aprsworld/dcswc_moduble_voltage_current_counter/hardware/dcswc_module_voltage_current_counter.pdf

## ICSP_PGD

## ICSP_PGC

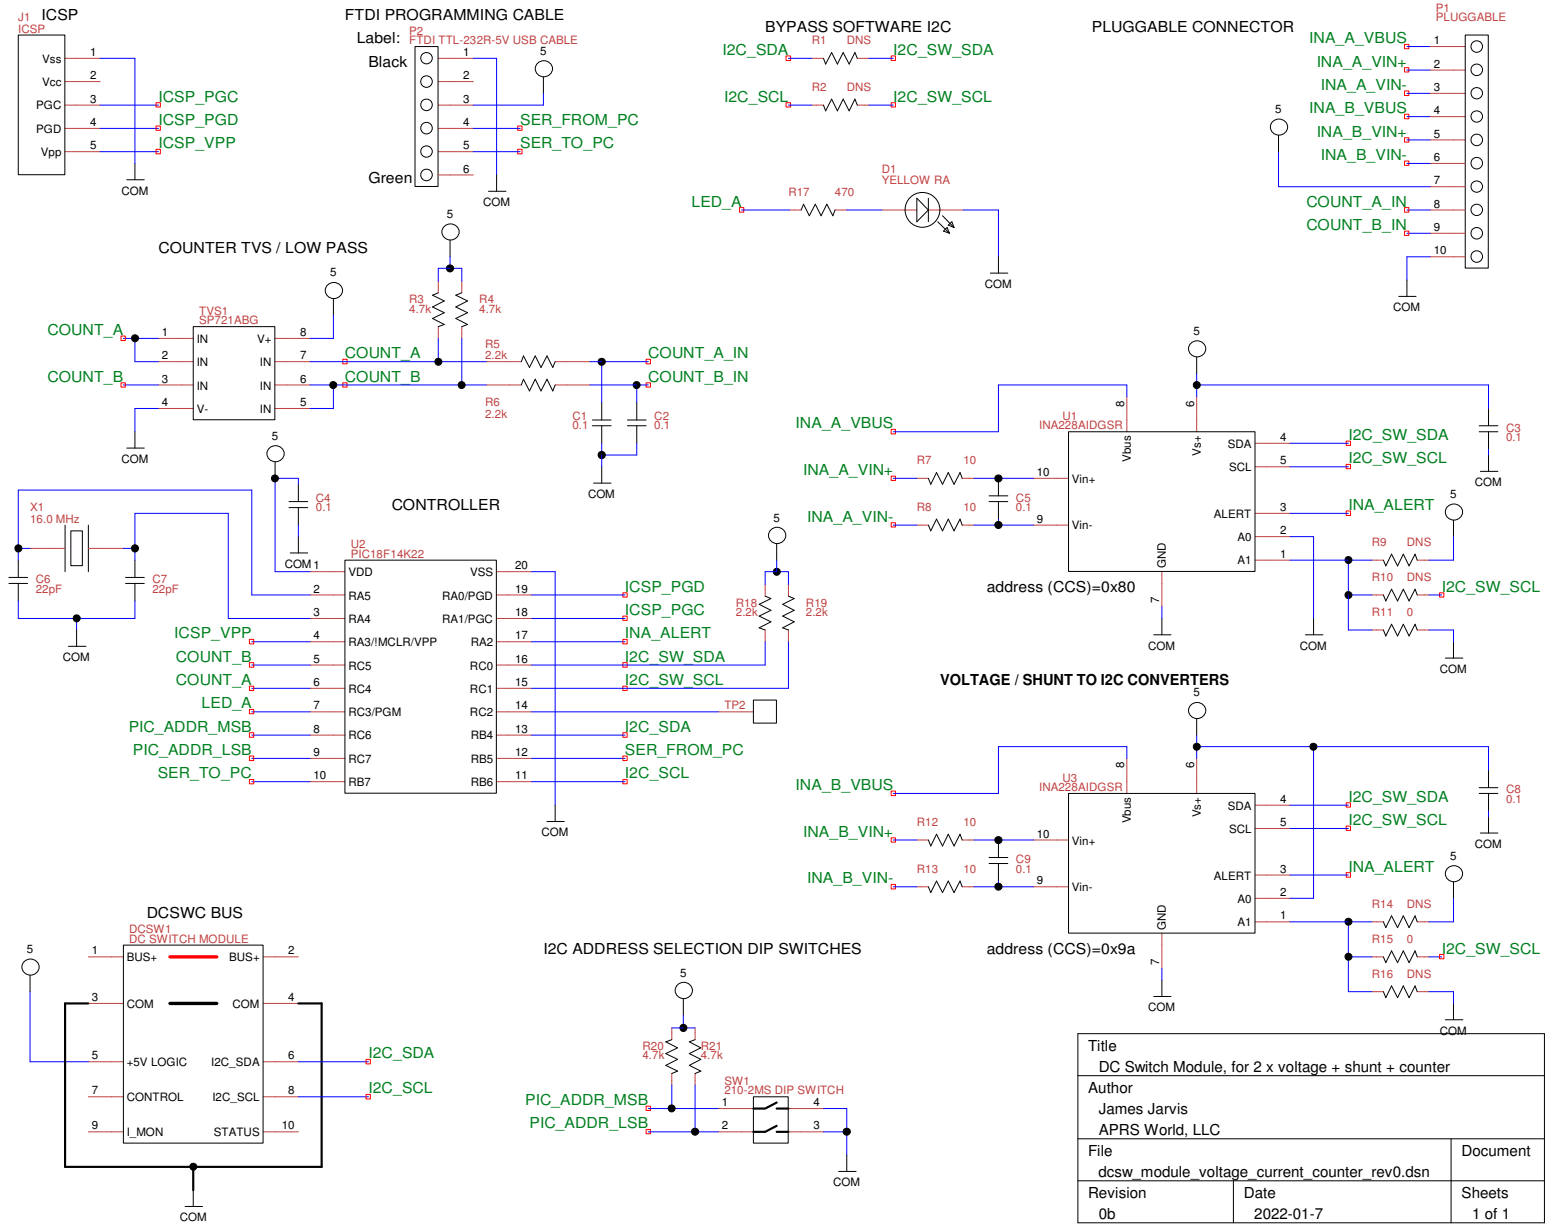
[picture p1: page 1]

COUNTER TVS / LOW PASS

I2C ADDRESS SELECTION DIP SWITCHES

Title
DC Switch Module, for 2 x voltage + shunt + counter
Author
James Jarvis
APRS World, LLC

File ... dcsw_module_voltage_current_counter_rev0.dsn | Document

Revision 0b | Date 2022-01-7 | Sheets 1 of 1
