aprsworld/dcswc_moduble_voltage_current_counter/param_dcswc_module_voltage_current_counter.c

#inline
char xor_crc(char oldcrc, char data) {
	return oldcrc ^ data;
}

char EEPROMDataRead( int16 address, int8 *data, int16 count ) {
	char crc=0;

	while ( count-- != 0 ) {
		*data = read_eeprom( address++ );
		crc = xor_crc(crc,*data);
		data++;
	}
	return crc;
}

char EEPROMDataWrite( int16 address, int8 *data, int16 count ) {
	char crc=0;

	while ( count-- != 0 ) {
		/* restart_wdt() */
		crc = xor_crc(crc,*data);
		write_eeprom( address++, *data++ );
	}

	return crc;
}

void write_param_file() {
	int8 crc;

	/* write the config structure */
	crc = EEPROMDataWrite(PARAM_ADDRESS,(void *)&config,sizeof(config));
	/* write the CRC was calculated on the structure */
	write_eeprom(PARAM_CRC_ADDRESS,crc);
}

void write_default_param_file() {
	current.default_params_written=1;

	/* both LEDs on */
	timers.led_on_a=150;

	config.serial_prefix='P';
	config.serial_number=9872;


	config.startup_power_on_delay=5;

	/* write them so next time we use from EEPROM */
	write_param_file();

}


void read_param_file() {
	int8 crc;

	crc = EEPROMDataRead(PARAM_ADDRESS, (void *)&config, sizeof(config)); 
		
	if ( crc != read_eeprom(PARAM_CRC_ADDRESS) ) {
		write_default_param_file();
	}
}
