aprsworld/dcswc_moduble_voltage_current_counter/(commit log)

2022-01-07 Working on getting software I2C master working
2022-01-08 Getting there. Trying to reduce counter jitter
    [dcswc_module_voltage_current_counter.c, dcswc_module_voltage_current_counter.h, interrupt_dcswc_module_voltage_current_counter.c, registers_dcswc_module_voltage_current_counter.h]
2022-01-08 DIP switches now work.
2022-01-10 Added I2C slave register mapping
2022-01-11 I2C address {0x36, 0x38, 0x3a, 0x38} based on DIP switch
2022-01-13 Hopefully I2C register access is working and we can get on with life
2022-02-05 Added schematic
2022-02-07 updated fuses and verified for meLabs
2022-02-08 Screwed up the fuses. Back to HS for external crystal
2024-04-10 Fixed VbusB MSW. Added filtering by default.
    [dcswc_module_voltage_current_counter.c, i2c_handler_dcswc_module_voltage_current_counter.c, ina228.c]
2024-04-11 Added I2C addess output on FTDI port
